OpenCore-Org/OpenCore/PCB/OpenCore_Carrier_Board/Project Outputs for OpenCore_Carrier_Board/BOM_OpenCore_Carrier_Board.xlsx

Comment | Description | Designator | Footprint | LibRef | Quantity | Manufacturer Part Number | order quantity
CAP_0402 | CAP CER 0.1UF 25V X5R 0402 | C200, C207, C208, C215, C220, C223, C224, C226, C231, C233, C234, C236, C300, C301, C303, C400, C401, C402, C403, C500, C502, C600, C602, C604, C700, C701, C702, C703, C704, C705, C706, C707, C708, C709, C800, C801, C802, C803, C804, C805, C806, C807, C808, C810, C811, C812, C813, C905, C906, C907, C908, C1000, C1001, C1002, C1003, C1200, C1201, C1202 | CAP0402 | CAP_CL05A104KA5NNNC | 58 | CL05A104KA5NNNC | 290
CAP_0402 | CAP CER 22PF 50V C0G/NP0 0402 | C201 | CAP0402 | CAP_CL05C220JB51PNC | 1 | CL05C220JB51PNC | 5
CAP_0805 | CAP CER 10UF 25V X5R 0805 | C204, C205, C206, C218, C219, C221, C222, C230, C232, C302, C304, C501, C503, C601, C603, C605 | CAP0805 | CAP_CL21A106KAYNNNE | 16 | CL21A106KAYNNNE | 80
CAP_0805 | CAP CER 22UF 25V X5R 0805 | C209, C210, C211, C212, C225, C227, C235, C237, C710, C711, C712, C713, C714, C900, C901, C902, C903, C904 | CAP0805 | CAP_CL21A226MAYNNNE | 18 | CL21A226MAYNNNE | 90
CAP_0402 | CAP CER 1UF 25V X5R 0603 | C214 | CAP0402 | CAP_CL10A105KA8NNNC | 1 | CL10A105KA8NNNC | 5
CAP_0402 | CAP CER 56PF 50V C0G/NPO 0402 | C216, C217 | CAP0402 | CAP_CC0402JRNPO9BN560 | 2 | CC0402JRNPO9BN560 | 10
CAP_0402 | CAP CER 120PF 50V C0G/NP0 0402 | C228, C229 | CAP0402 | CAP_CL05C121JB51PNC | 2 | CL05C121JB51PNC | 10
CAP_0402 | CAP CER 0.047UF 25V X7R 0402 | C1004 | CAP0402 | CAP_GRM155R71E473KA88D | 1 | GRM155R71E473KA88D | 5
ESD321DYAR | TVS DIODE 3.6VWM 6.3VC SOT5X3 | D304, D305, D400, D401, D402, D901, D902, D904, D905, D906 | TI_SOD523 | ESD321DYAR | 10 | ESD321DYAR | 50
TVS DIODE 15VWM 24.4VC DO214AC | 24.4V Clamp 16.4A Ipp Tvs Diode Surface Mount DO-214AC (SMA) | D900 | LITTLEFUSE_DO-2014 | SMAJ15CA | 1 | SMAJ15CA | 5
S1A-13-F | Diode 50 V 1A Surface Mount SMA | D903 | DIODES_SMA | S1A-13-F | 1 | S1A-13-F | 5
ESD9B5.0ST5G | TVS DIODE 5VWM SOD923 | D1000 | ONSEMI_SOD-923 | ESD9B5.0ST5G | 1 | ESD9B5.0ST5G | 5
GENERIC LED - ORANGE | GENERIC LED - ORANGE | D1100, D1101 | LED_0603 | .LED_ORANGE | 2 |  | 10
GENERIC LED - GREEN | GENERIC LED - GREEN | D1102, D1103, D1104, D1105, D1106, D1107, D1108, D1109 | LED_0603 | .LED_GREEN | 8 |  | 40
FUSE_4A_0603 | FUSE SMD 4A 32V | F900 | FUSE_0603 | FUSE_4A_0603 | 1 |  | 5
M20-9770246 | CONN HEADER VERT 2POS 2.54MM | J301, J401, J402, J403, J902 | 61300211121 | M20-9770246 | 5 | M20-9770246 | 25
0472720001 | CONN RCPT DISPLAYPORT 20P SMD RA | J800 | 0472720001 | 0472720001 | 1 | 0472720001 | 5
0455580003 | Connector Header Through Hole, Right Angle 6 position 0.165" (4.20mm) | J900 | 0455580003 | 0455580003 | 1 | 0455580003 | 5
FTSH-105-01-F-DV-K | CONN HEADER SMD 10POS 1.27MM | J901 | FTSH-105-01-F-DV-K-P-TR | FTSH-105-01-F-DV-K | 1 | FTSH-105-01-F-DV-K | 5
IHLP5050CEER1R5M01 | FIXED IND 1.5UH 19A 5.5 MOHM SMD | L200 | IHLP5050CEER1R5M01 | IND_IHLP5050CEER1R5M01 | 1 | IHLP5050CEER1R5M01 | 5
SDCHA1V6045-2R2-R | IND SMD POWER 2.2UH 6.0A | L201, L202 | SDCHA1V6045-2R2-R | IND_SDCHA1V6045-2R2-R | 2 | SDCHA1V6045-2R2-R | 10
DFE252012F-1R0M | FIXED IND 1UH 3.3A 0.04OHM SMD | L203, L204 | IND_2520 | IND_DFE252012F-1R0M | 2 | DFE252012F-1R0M | 10
BSS138PW,115 | MOSFET N-CH 60V 320MA SOT323 | Q1100, Q1101, Q1102, Q1103, Q1104, Q1105, Q1106, Q1107, Q1108, Q1109, Q1200, Q1201 | NEXPERIA_SOT323 | BSS138PW,115 | 12 | BSS138PW,115 | 60
RES_0402 | RES 100K OHM 1% 1/16W 0402 | R200, R206, R219, R220, R804, R805, R812 | RES0402 | .RES_RC0402FR-07100KL | 7 | RC0402FR-07100KL | 35
RES_0402 | RES 0 OHM JUMPER 1/16W 0402 | R201, R203, R207, R209, R213, R214, R215, R217, R300, R301, R303, R304, R703, R707, R806, R809, R810, R811, R904, R905, R1201, R1202 | RES0402 | .RES_RC0402JR-070RL | 22 | RC0402JR-070RL | 110
RES_0402 | RES 147K OHM 1% 1/16W 0402 | R202 | RES0402 | .RES_RC0402FR-07147KL | 1 | RC0402FR-07147KL | 5
RES_0402 | RES 20K OHM 1% 1/16W 0402 | R204, R205 | RES0402 | .RES_RC0402FR-0720KL | 2 | RC0402FR-0720KL | 10
RES_0402 | RES 45.3K OHM 1% 1/16W 0402 | R208, R210 | RES0402 | .RES_RC0402FR-0745K3L | 2 | RC0402FR-0745K3L | 10
RES_0402 | RES 10K OHM 1% 1/16W 0402 | R211, R212, R402, R1200, R1204 | RES0402 | .RES_RC0402FR-0710KL | 5 | RC0402FR-0710KL | 25
RES_0402 | RES 200K OHM 1% 1/16W 0402 | R216, R218 | RES0402 | .RES_RC0402FR-07200KL | 2 | RC0402FR-07200KL | 10
RES_0402 | RES 4.7K OHM 1% 1/16W 0402 | R305, R400, R401, R700, R900, R901, R902, R903 | RES0402 | .RES_RC0402FR-074K7L | 8 | RC0402FR-074K7L | 40
RES_0402 | RES 2.49K OHM 1% 1/16W 0402 | R800 | RES0402 | .RES_RC0402FR-072K49L | 1 | RC0402FR-072K49L | 5
RES_0402 | RES 1.5K OHM 1% 1/16W 0402 | R801 | RES0402 | .RES_RC0402FR-071K5L | 1 | RC0402FR-071K5L | 5
RES_0402 | RES 49.9 OHM 1% 1/16W 0402 | R802, R803 | RES0402 | .RES_RC0402FR-0749R9L | 2 | RC0402FR-0749R9L | 10
RES_0402 | RES 1M OHM 1% 1/16W 0402 | R807, R808 | RES0402 | .RES_RC0402FR-071ML | 2 | RC0402FR-071ML | 10
 |  |  |  |  |  |  | 0
RES_0402 | RES 300 OHM 1% 1/16W 0402 | R1100, R1101, R1104, R1105, R1106, R1107, R1108, R1109, R1110, R1111 | RES0402 | .RES_RC0402FR-07300RL | 10 | RC0402FR-07300RL | 50
RES_0402 | RES 33 OHM 1% 1/16W 0402 | R1203, R1205, R1206, R1207 | RES0402 | .RES_RC0402FR-0733RL | 4 | RC0402FR-0733RL | 20
SW_SLIDE_TOGGLE | SWITCH SLIDE SPDT 5A 28V | S900 | 500SSP1S2M2QEA | SW_SLIDE_TOGGLE | 1 | 500SSP1S2M2QEA | 5
PTS_647_SN50_SMTR2_LFS | SWITCH TACTILE SPST-NO 0.05A 12V | SW1000 | TACTILE_SW_4.5MM | PTS_647_SN50_SMTR2_LFS | 1 | PTS_647_SN50_SMTR2_LFS | 5
TPS51386RJNR | IC REG BUCK ADJ 8A 12-PowerVFQFN | U200 | TI_RJN0012A_POWERVQFN12 | TPS51386RJNR | 1 | TPS51386RJNR | 5
TPS563257DRLR | IC REG BUCK ADJ 3A SOT563 | U201, U202 | TI_SOT6_DRL0006A | TPS563257DRLR | 2 | TPS563257DRLR | 10
TPS62A01ADRL | IC REG BUCK ADJ 1A SOT5X3 | U203, U204 | TI_SOT6_DRL0006A | TPS62A01ADRL | 2 | TPS62A01ADRL | 10
74LVC1T45GW,125 | IC TRANSLTR BIDIRECTIONAL 6TSSOP | U700 | NEXPERIA_TSSOP6 | 74LVC1T45GW,125 | 1 | 74LVC1T45GW,125 | 5
74AVC4T245PW,118 | IC TRANSLATION TXRX 3.6V 16TSSOP | U800 | SOP65P640X110-16N | 74AVC4T245PW,118 | 1 | 74AVC4T245PW,118 | 5
SN65LVDS180PWR | IC TRANSCEIVER FULL 1/1 14TSSOP | U801 | TI_TSSOP14_PW | SN65LVDS180PWR | 1 | SN65LVDS180PWR | 5
824012823 | TVS DIODE 3.3VWM 13VC DFN1210-6 | U802 | 824012823 | 824012823 | 1 | 824012823 | 5
SN74LXC1T14DCKR | IC TRANSLATOR UNIDIR SC70-5 | U1000 | TI_SC70_DCK0005A | SN74LXC1T14DCKR | 1 | SN74LXC1T14DCKR | 5
TPS3840PH30DBVR | IC SUPERVISOR 1 CHANNEL SOT23-5 | U1001 | TI_SOT23_DBV0005A | TPS3840PH30DBVR | 1 | TPS3840PH30DBVR | 5
DSC1123CI1-027.0000 | MEMS OSC XO 27.0000MHZ LVDS SMD | U1200 | MICROCHIP_VDFN-6_H5A | DSC1123CI1-027.0000 | 1 | DSC1123CI1-027.0000 | 5
DSC557-0344FI0T | IC CLOCK GEN PCIE 14QFN | U1201 | MICROCHIP_QFN2532-14 | DSC557-0344FI0T | 1 | DSC557-0344FI0T | 5
