OpenCore-Org/OpenCore/PCB/3D Models/VDFN6_3P2X2P5_MCH.step

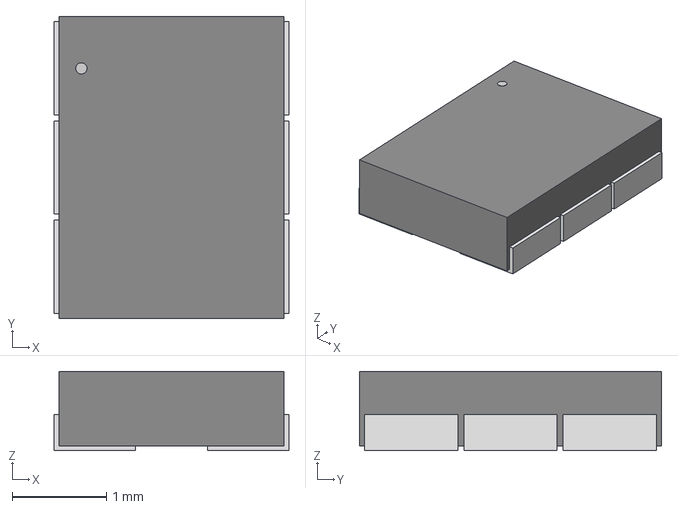
[picture p1: CAD file, 2025-03-09]
PCB/3D Models/VDFN6_3P2X2P5_MCH.step
2.49 x 3.20 x 0.841 mm
