OpenCore-Org/OpenCore/PCB/3D Models/DYA0002A.stp

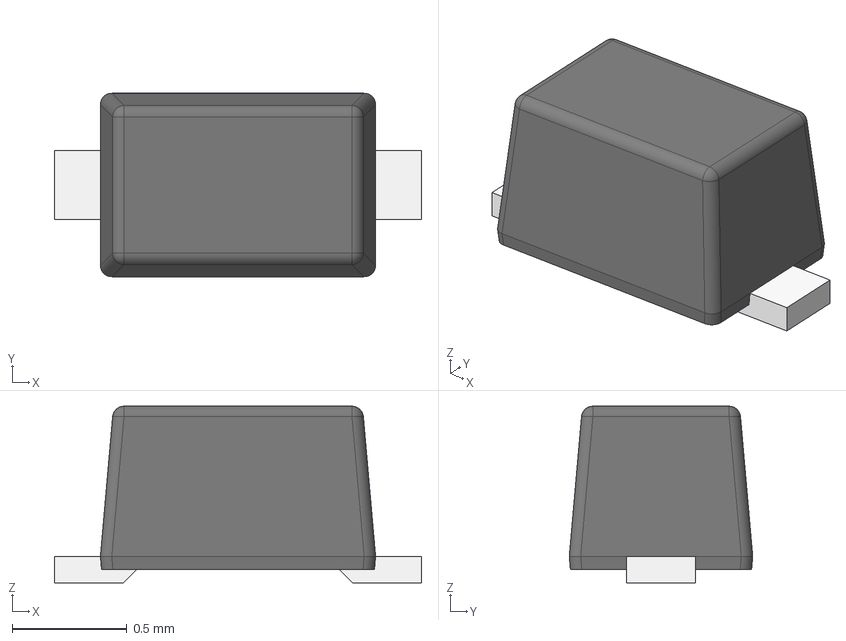
[picture p2: CAD file, 2025-03-09]
PCB/3D Models/DYA0002A.stp
1.60 x 0.8 x 0.77 mm
FRAME-DYA0002A
BODY-SOT
PIN1-ID
