OpenCore-Org/OpenCore/PCB/3D Models/ESD9B5.0ST5G.step

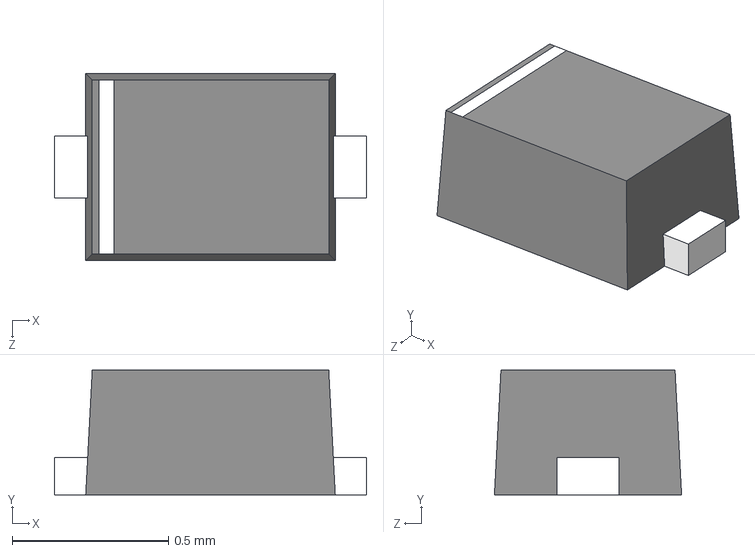
[picture p3: CAD file, 2025-03-09]
PCB/3D Models/ESD9B5.0ST5G.step
1 x 0.4 x 0.6 mm
