OpenCore-Org/OpenCore/PCB/3D Models/CR_02V-G3-08_VIS.step

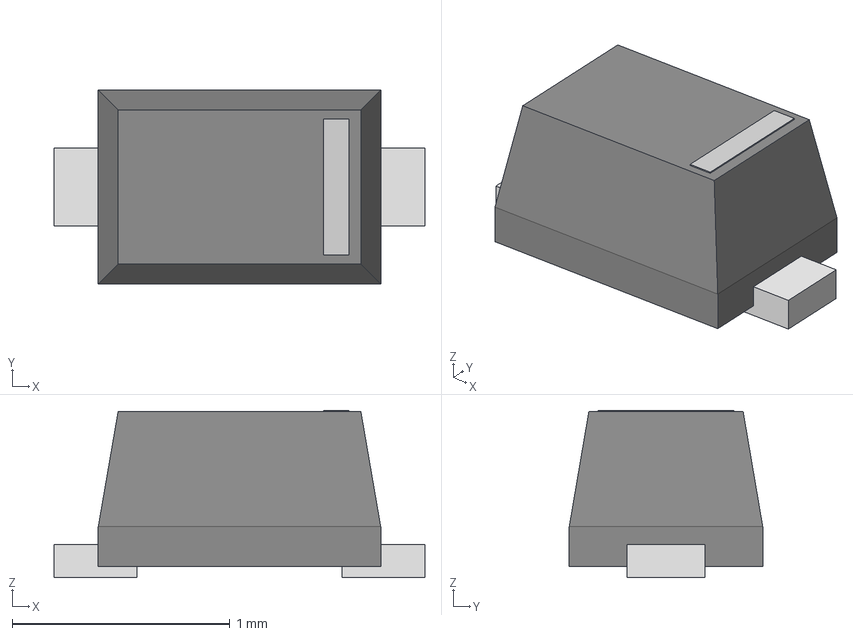
[picture p4: CAD file, 2025-03-09]
PCB/3D Models/CR_02V-G3-08_VIS.step
1.70 x 0.888 x 0.768 mm
