OpenCore-Org/OpenCore/PCB/3D Models/VQFN14_MUA_1p4x2p1EP_MCH.step

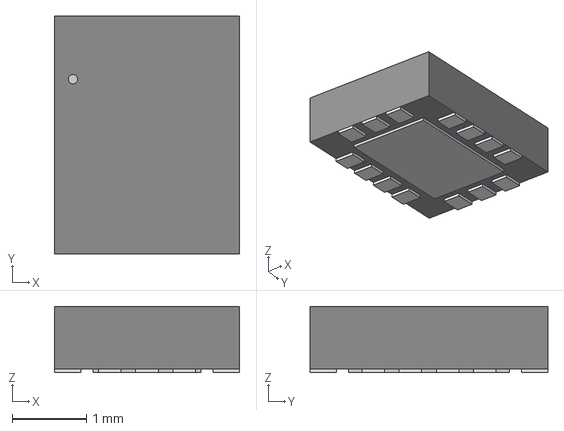
[picture p5: CAD file, 2025-03-09]
PCB/3D Models/VQFN14_MUA_1p4x2p1EP_MCH.step
2.49 x 3.20 x 0.892 mm
