OpenCore-Org/OpenCore/PCB/3D Models/SDCHA1V6045.stp

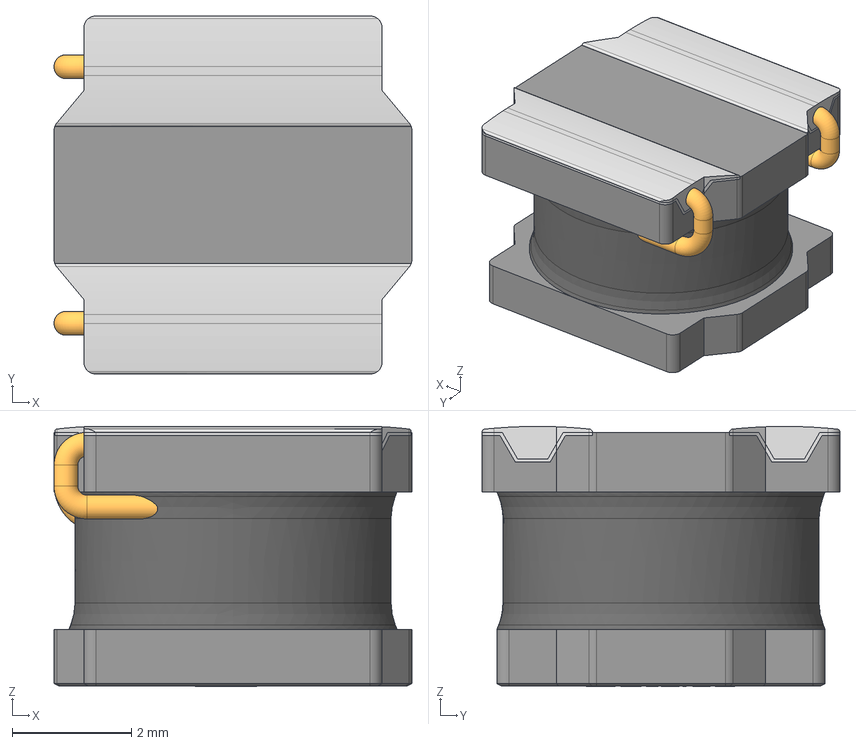
[picture p6: CAD file, 2025-03-09]
PCB/3D Models/SDCHA1V6045.stp
6.00 x 6.00 x 4.36 mm
