OpenCore-Org/OpenCore/PCB/3D Models/IHLP5050CE (0.68-10uH).STEP

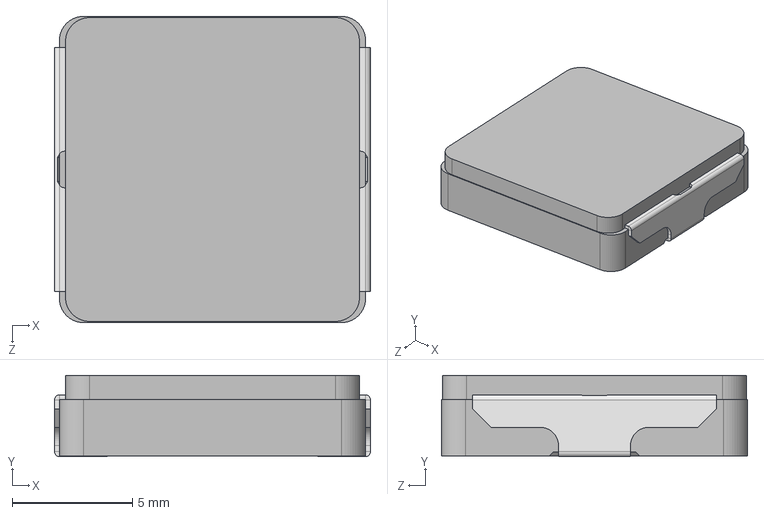
[picture p7: CAD file, 2025-03-09]
PCB/3D Models/IHLP5050CE (0.68-10uH).STEP
13.2 x 3.39 x 12.8 mm
