OpenCore-Org/OpenCore/PCB/3D Models/PTS647SN50SMTR2LFS.stp

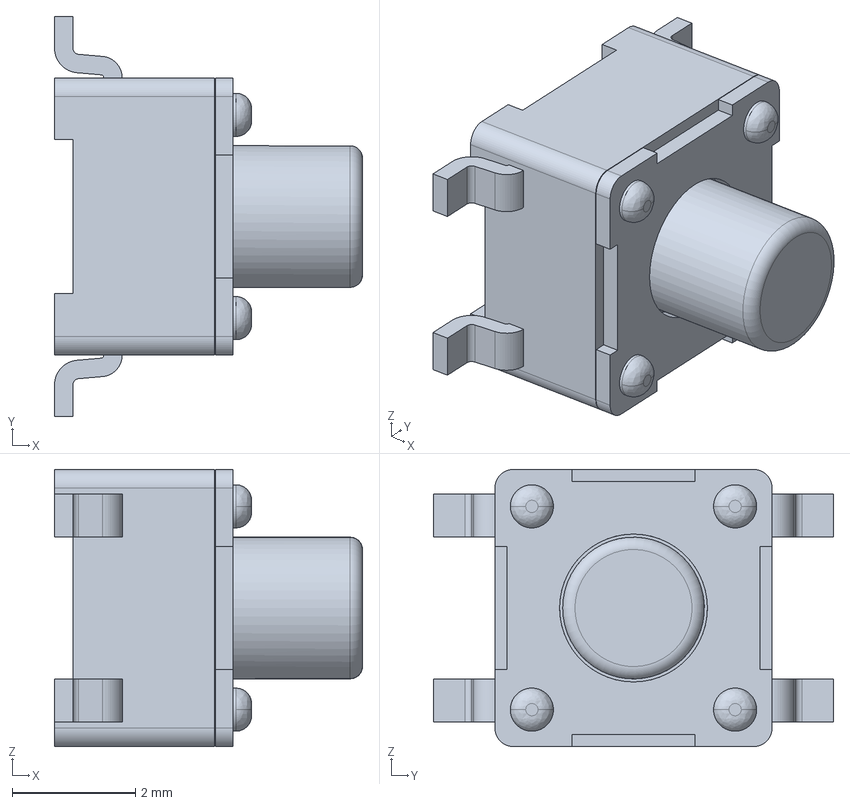
[picture p8: CAD file, 2025-03-09]
PCB/3D Models/PTS647SN50SMTR2LFS.stp
5.00 x 6.50 x 4.50 mm
