OpenCore-Org/OpenCore/PCB/3D Models/SMASeries_LTF.step

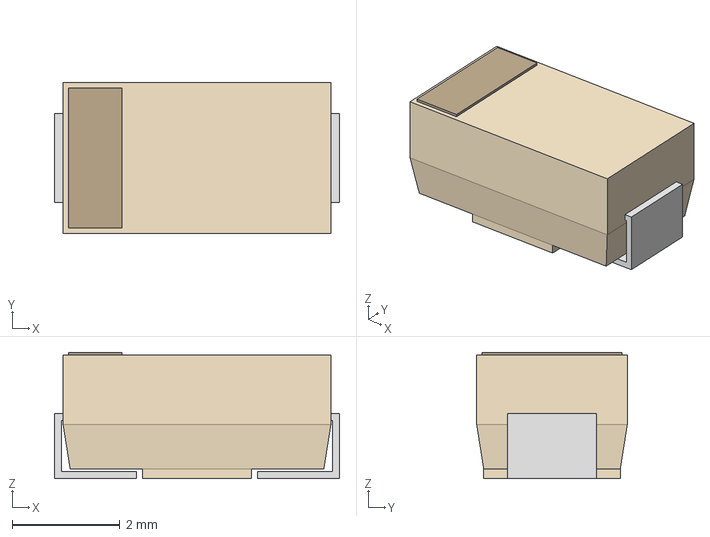
[picture p9: CAD file, 2025-03-09]
PCB/3D Models/SMASeries_LTF.step
5.28 x 2.79 x 2.34 mm
