OpenCore-Org/OpenCore/PCB/3D Models/Wurth_61300211121.stp

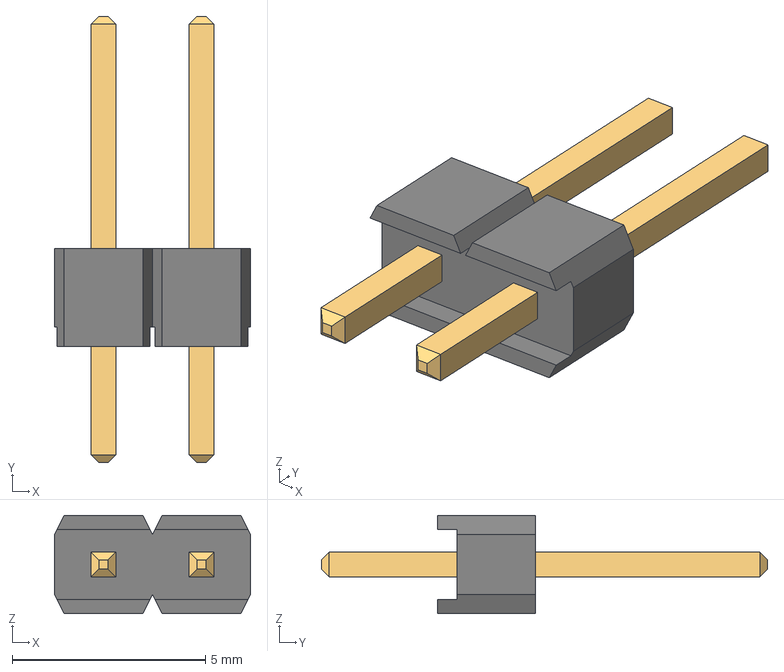
[picture p10: CAD file, 2025-03-09]
PCB/3D Models/Wurth_61300211121.stp
5.08 x 11.5 x 2.54 mm
6130xx11121_PIN x 2
