OpenCore-Org/OpenCore/PCB/3D Models/Wurth_150060xS75000_rev1.stp

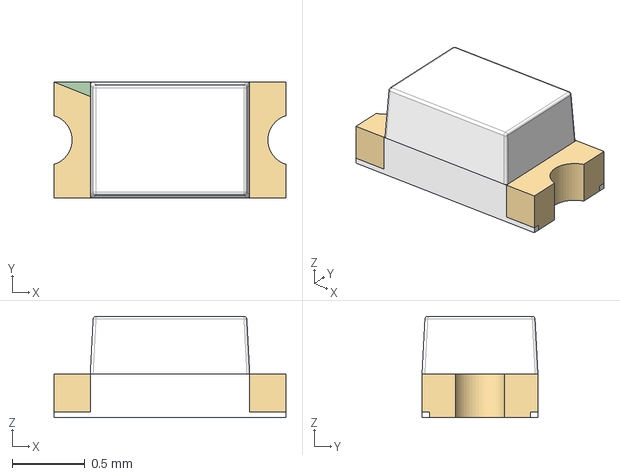
[picture p11: CAD file, 2025-03-09]
PCB/3D Models/Wurth_150060xS75000_rev1.stp
1.60 x 0.8 x 0.7 mm
