OpenCore-Org/OpenCore/PCB/3D Models/SMA_DIO.step

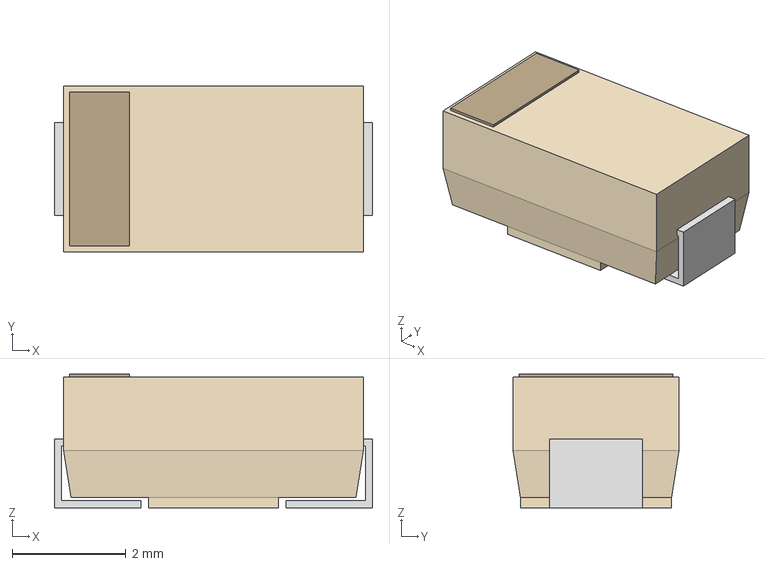
[picture p12: CAD file, 2025-03-09]
PCB/3D Models/SMA_DIO.step
5.59 x 2.92 x 2.35 mm
