OpenCore-Org/OpenCore/PCB/3D Models/SOT323.step

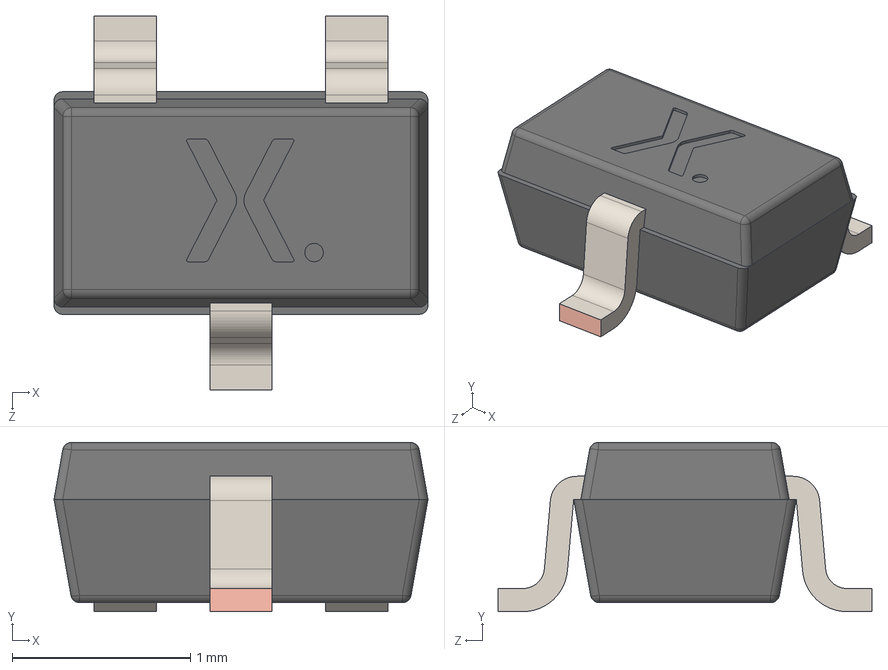
[picture p13: CAD file, 2025-03-09]
PCB/3D Models/SOT323.step
2.10 x 0.95 x 2.10 mm
Upper body
lower body
Lead x 3
