OpenCore-Org/OpenCore/PCB/3D Models/TPS51385RJNR.step

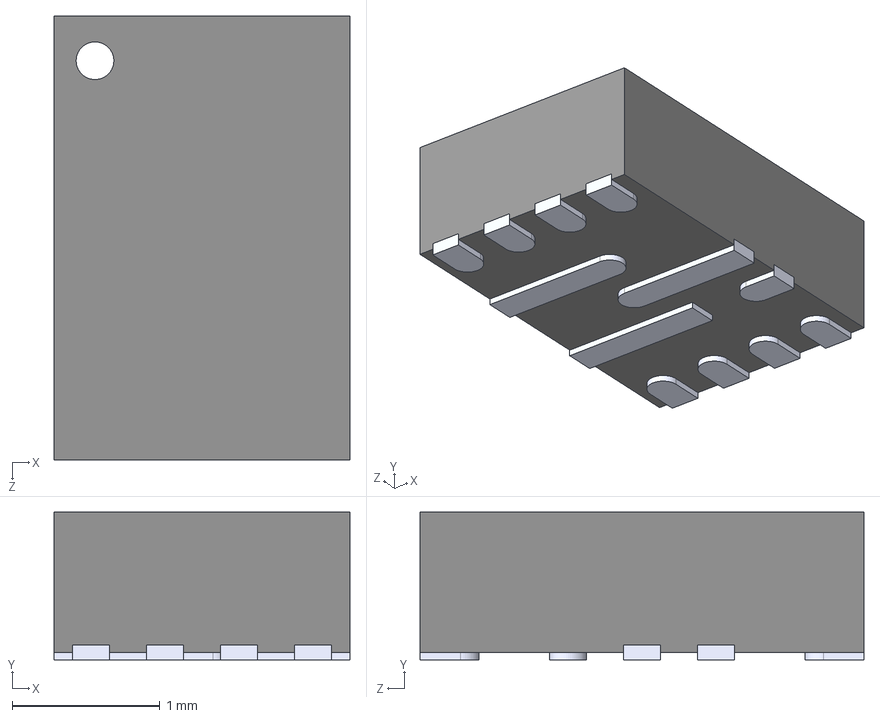
[picture p14: CAD file, 2025-03-09]
PCB/3D Models/TPS51385RJNR.step
2.00 x 1.00 x 3.00 mm
