OpenCore-Org/OpenCore/PCB/3D Models/DFE252012F-1R0M_3DP2.STEP

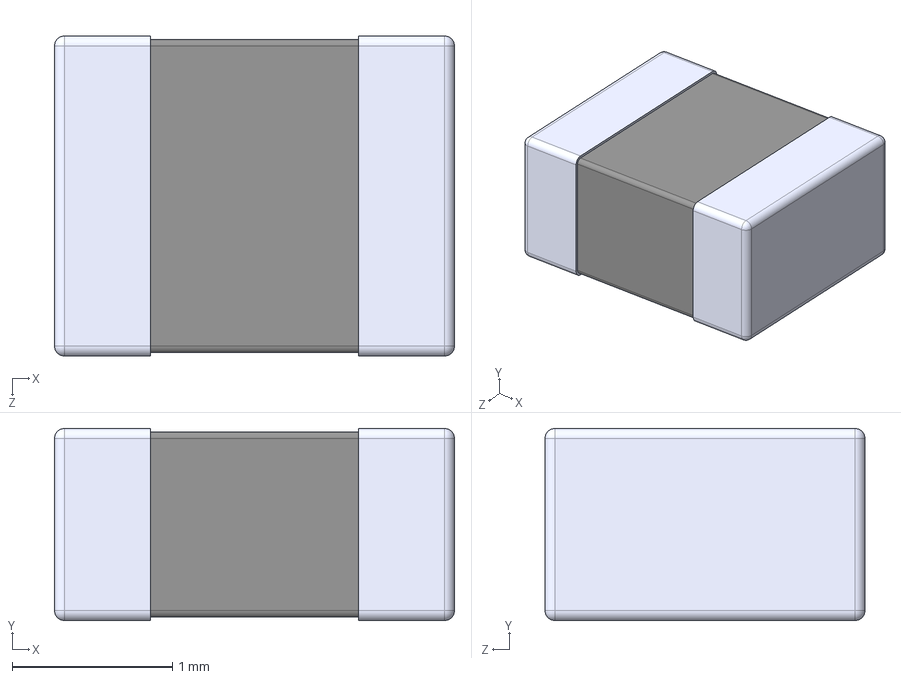
[picture p15: CAD file, 2025-03-09]
PCB/3D Models/DFE252012F-1R0M_3DP2.STEP
2.50 x 1.20 x 2.00 mm
