OpenCore-Org/OpenCore/OpenCoreRTL/veril/decode_testbench/instruction_list.txt

7E080280
BFA10002
F4000082 FA00002C
F4040002 FA000048
F4040202 FA000018
BEA10380
BF8CC07F
8701FF02 0000FFFF
D5767D00 04000206
BF028009
D70F7D02 00020000
850080C1
7D080408
8700006A
87007E00
BEFE0500
BF840026
F4040002 FA000010
3006049F
D6FF0000 00020482
D5690002 00001302
3006049F
D6FF0002 00020482
BF8CC07F
D70F6A00 00020000
50020201
F4080002 FA000000
DC308000 057D0000
BF8CC07F
D70F6A02 00020400
50060601
DC308000 067D0002
DC308000 07020004
D70F6A02 00010902
8109C109
50060680
80028402
82038003
BF078009
BF8C3F70
560A0F06
DC708000 007D0500
BF85FFF0
BF810000
7E080280
BFA10002
F4000082 FA00002C
F4040002 FA000048
F4040202 FA000018
BEA10380
BF8CC07F
8701FF02 0000FFFF
D5767D00 04000206
BF028008
D70F7D00 00020000
850080C1
7D080009
8700006A
87007E00
BEFE0500
BF84002D
F4080002 FA000000
3002009F
F4040102 FA000010
D6FF0002 00020082
BF8CC07F
D70F6A02 00020402
50060603
DC308000 057D0002
BF800000
BF800000
BF800000
BF800000
BF800000
BF800000
BF800000
BF800000
BF800000
BF800000
BF800000
BF800000
3002009F
8108C108
D6FF0006 00020082
4A000009
D70F6A06 00020C00
500E0E01
DC308000 01040004
DC308000 067D0006
80048404
82058005
BF078008
BF8C3F70
560A0306
DC708000 007D0502
BF85FFEC
BF810000
BEA10380
BFA10002
F4000282 FA000024
F4080002 FA000040
F4040202 FA000010
BF8CC07F
8701FF0A 0000FFFF
9003900A
93060106
93070307
D76D0000 04000C00
D76D0001 04040E02
8100C109
8102C108
7D080000
D4810000 00020280
D4810001 00020080
D4840002 00020202
8700006A
87000001
87000002
87007E00
BEFE0500
BF840063
4A0402C1
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
DC708004 007D0406
DC708004 007D050C
BF8CC17F
DC708004 007D080E
DC708004 007D0910
BF8CC07F
DC708004 007D0A12
4A0C06FF 00000200
D8DCEEDD 04000003
D70F6A02 00004D00
50060227
D8DC907F 06000006
D70F6A08 00005500
5012022B
D70F6A0C 00005D00
501A022F
D70F6A0E 00006100
501E0231
D70F6A00 00006500
50020233
DC708004 007D0B02
BF8CC17F
DC708004 007D0408
DC708004 007D050C
BF8CC07F
DC708004 007D060E
DC708004 007D0700
BF810000
