OpenCore-Org/OpenCore/(list of files, drawings)

Other design files:
PCB/OpenCore_Carrier_Board/OpenCore_Carrier_Board.PrjPcb
PCB/OpenCore_Carrier_Board/OpenCore_Sch_Lib.SchLib
PCB/OpenCore_Carrier_Board/S01_Block_Diagram.SchDoc
PCB/OpenCore_Carrier_Board/S02_Power_Converters.SchDoc
PCB/OpenCore_Carrier_Board/S03_SOM1_A_B.SchDoc
PCB/OpenCore_Carrier_Board/S04_SOM1_C_D.SchDoc
PCB/OpenCore_Carrier_Board/S05_SOM2_A_B.SchDoc
PCB/OpenCore_Carrier_Board/S06_SOM2_C_D.SchDoc
PCB/OpenCore_Carrier_Board/S07_PCIe_Connector.SchDoc
PCB/OpenCore_Carrier_Board/S08_DisplayPort.SchDoc
PCB/OpenCore_Carrier_Board/S09_Connectors.SchDoc
PCB/OpenCore_Carrier_Board/S10_Reset_Logic.SchDoc
PCB/OpenCore_Carrier_Board/S11_LEDs.SchDoc
PCB/OpenCore_Carrier_Board/S12_Clocks.SchDoc
