OpenCore-Org/OpenCore/(notices)

Notices in the files:
PCB/3D Models/PTS647SN50SMTR2LFS.stp:
author */ ('License CC BY-ND 4.0'),
